mtraver/retroblue/(commit log)

2014-04-30 Add basic Arduino sketch
2014-05-03 In issueCommand, remove terminator from response immediately, and change prints.
    [retroblue.ino]
2014-05-03 Add a delay after phone is taken off the hook so that phone state can stabilize
    We were sometimes seeing a number being "dialed" when we took the phone off the hook. This should prevent that.
    [retroblue.ino]
2014-05-04 Debugging prints
2014-05-04 Add short delay after getting a dialed number
    [retroblue.ino]
2014-05-05 Modify some debugging prints
2014-05-06 Make wrappers for Serial.print and Serial.println that only print when DEBUG is true.
    Arduino seems to block when no console is open to accept data sent over the serial port,
    so now DEBUG can be set to false when the Arduino isn't plugged into a computer.
2014-05-07 Only call Serial.begin is DEBUG is true, and convert some ints to Strings before printing
2014-05-07 Add constants for getDialedNumber return values, and fix int to String conversion when calling print/println
    [retroblue.ino]
2014-05-07 Make getDialedNumber return INVALID_DIAL if a number greater than 10 is detected.
    This means something went wrong with the dialing cycle; maybe the user kept
    the dial from returning at its natural speed.
    [retroblue.ino]
2014-05-07 Get rid of resetPin
    [retroblue.ino]
2014-05-08 Add Bluetooth/Arduino interface and audio implementation subsections. Also add audio quality improvement to improvements section.
2014-05-08 Remove solenoid state debugging prints
2014-05-08 Add "The Code" and "Circuit Consolidation and Mounting" subsections to Implementation section
2014-05-08 Add voltage level converter website to bibliography
2014-05-08 Increase size of dialing state images
    It was hard to see whether the switches were open or closed when the images were so small
